RenoZhao19/Hexfellow-Teleop-Leader-Arm-Design/Checks/Measured_CAD_shafts.csv

side | axis | component | largest matching cylindrical diameter mm | direction residual (sine of unsigned angle) | perpendicular shaft offset mm | matching cylindrical face count
Left | 1 | J1_XM430_drive_horn | 19.5 | 0.0 | 0.0 | 6
Left | 2 | M2_XM430_drive_horn | 19.5 | 0.0 | 0.0 | 3
Left | 3 | M3_XC330_horn | 16.0 | 0.0 | 0.0 | 14
Left | 4 | M4_XM430_drive_horn | 19.5 | 0.0 | 0.0 | 3
Left | 5 | M5_XC330_horn | 16.0 | 0.0 | 0.0 | 14
Left | 6 | M6_XC330_horn | 16.0 | 0.0 | 0.0 | 14
Left | 7 | M7_XC330_horn | 16.0 | 0.0 | 0.0 | 14
Right | 1 | J1_XM430_drive_horn | 19.5 | 0.0 | 0.0 | 6
Right | 2 | M2_XM430_drive_horn | 19.5 | 0.0 | 0.0 | 3
Right | 3 | M3_XC330_horn | 16.0 | 0.0 | 0.0 | 14
Right | 4 | M4_XM430_drive_horn | 19.5 | 0.0 | 0.0 | 3
Right | 5 | M5_XC330_horn | 16.0 | 0.0 | 0.0 | 14
Right | 6 | M6_XC330_horn | 16.0 | 0.0 | 0.0 | 14
Right | 7 | M7_XC330_horn | 16.0 | 0.0 | 0.0 | 14
