RenoZhao19/Hexfellow-Teleop-Leader-Arm-Design/Assemblies/Right_leader.step

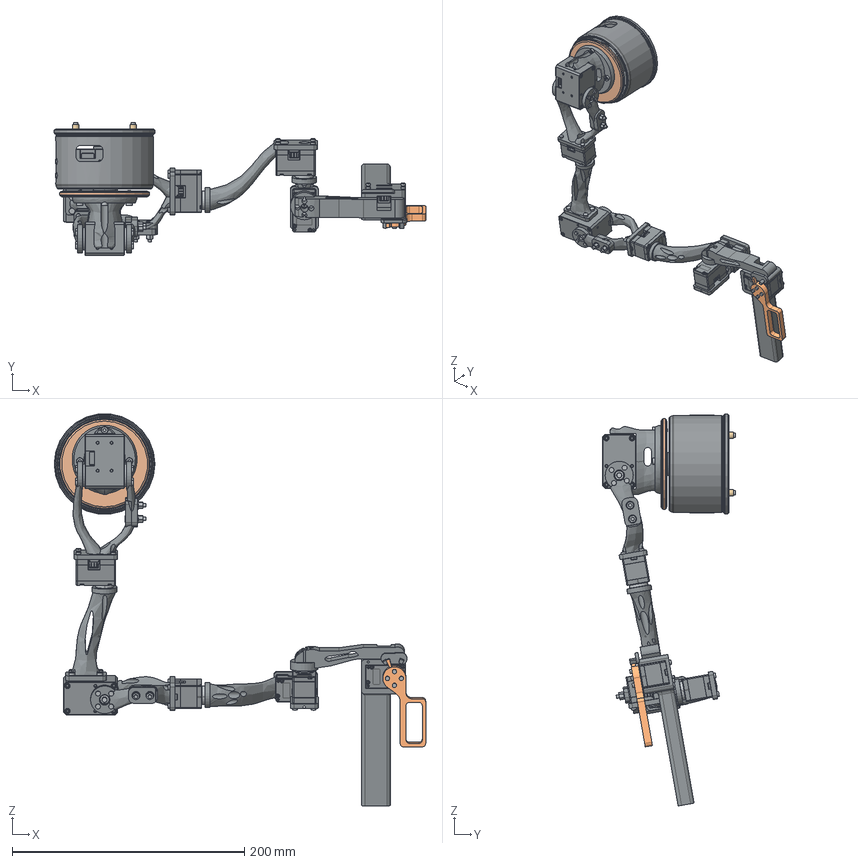
[picture p8: CAD file, 2026-11-11]
Assemblies/Right_leader.step
319.8 x 114.2 x 337.4 mm
Right_L2_Upper_fork
Right_L2_Upper_service_cheek
Right_M2_XM430_case
Right_M2_XM430_drive_horn
Right_M2_XM430_idler
Right_F1_Exterior_fasteners
Right_J1_Fixed_external_drum
Right_J1_XM430_fixed_case
Right_J1_XM430_drive_horn
Right_J1_Drum_mount_M4x14
Right_J1_Torso_M4_inserts
Right_J1_Case_mount_M25x7
Right_J1_Rotating_faceplate
Right_J1_J2_Swept_motor_saddle
Right_J1_Horn_drive_screws_M2x6
Right_J1_Saddle_screws_M3x10
Right_J1_Saddle_captive_nuts_M3
Right_L4_Elbow_fork
Right_L4_Elbow_service_cheek
Right_L3_Upper_bone
Right_L5_Forearm_bone
Right_L6_Wrist_saddle
Right_M3_XC330_case
Right_M3_XC330_horn
Right_M4_XM430_case
Right_M4_XM430_drive_horn
Right_M4_XM430_idler
Right_M5_XC330_case
Right_M5_XC330_horn
Right_M6_XC330_case
Right_M6_XC330_horn
Right_M7_XC330_case
Right_F2_Exterior_fasteners
Right_F3_Exterior_fasteners
Right_F4_Exterior_fasteners
Right_F5_Exterior_fasteners
Right_F6_Exterior_fasteners
Right_M7_XC330_horn
Right_FACTR_palm
Right_FACTR_trigger
Right_J8_XC330_T288T_case
Right_J8_XC330_T288T_horn
Right_J7_grip_screws
Right_J8_case_screws
Right_J8_trigger_screws
