RenoZhao19/Hexfellow-Teleop-Leader-Arm-Design/CAD_Source/grip/trigger.step

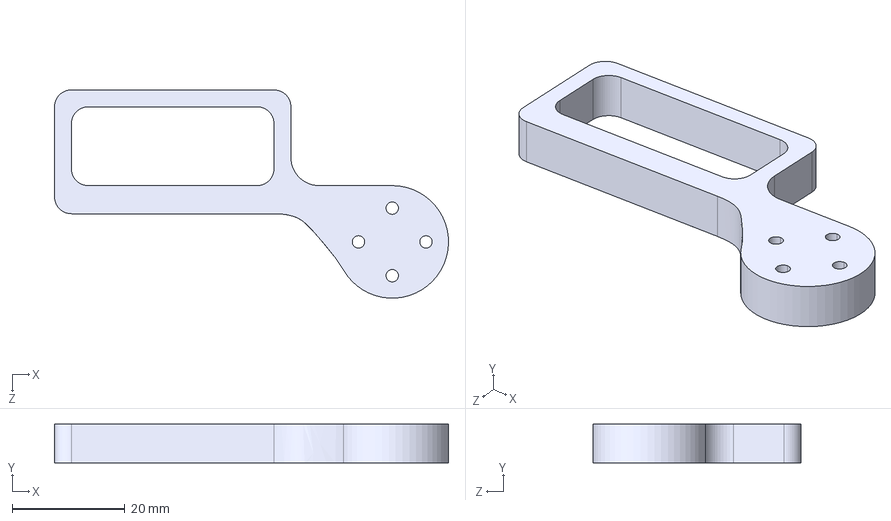
[picture p9: CAD file, 2026-11-11]
CAD_Source/grip/trigger.step
70.0 x 6.90 x 37.0 mm
