RenoZhao19/Hexfellow-Teleop-Leader-Arm-Design/Parts/Metal/F03_Square_mast_40x40x2_L453.step

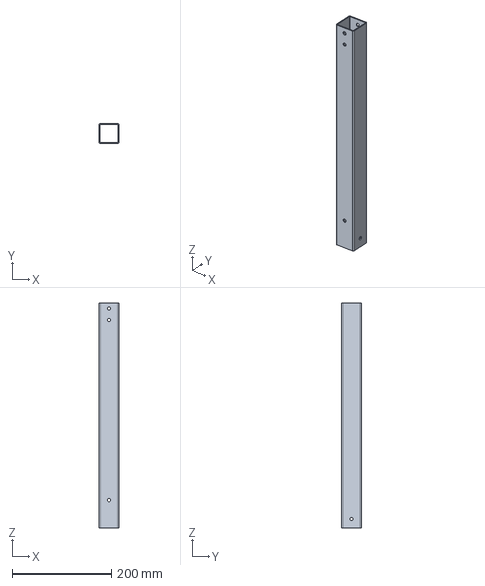
[picture p10: CAD file, 2026-11-11]
Parts/Metal/F03_Square_mast_40x40x2_L453.step
40.0 x 40.0 x 453.0 mm
