RenoZhao19/Hexfellow-Teleop-Leader-Arm-Design/Parts/Printable_STEP/J1_Fixed_external_drum.step

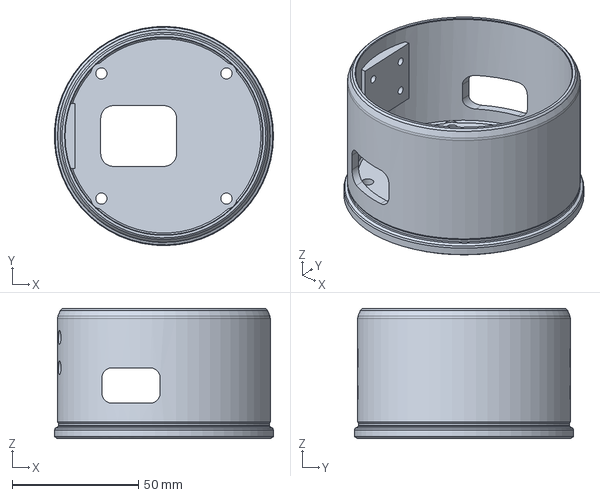
[picture p11: CAD file, 2026-11-11]
Parts/Printable_STEP/J1_Fixed_external_drum.step
86.6 x 86.7 x 51.5 mm
