RenoZhao19/Hexfellow-Teleop-Leader-Arm-Design/CAD_Source/grip/handle.step

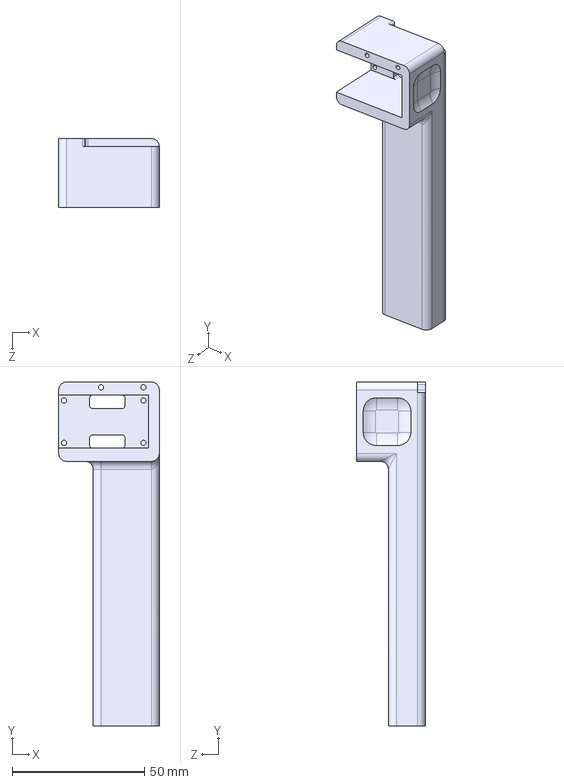
[picture p12: CAD file, 2026-11-11]
CAD_Source/grip/handle.step
38.0 x 130.0 x 26.0 mm
