RenoZhao19/Hexfellow-Teleop-Leader-Arm-Design/Parts/Metal/F04_Mast_sleeve_36mm.step

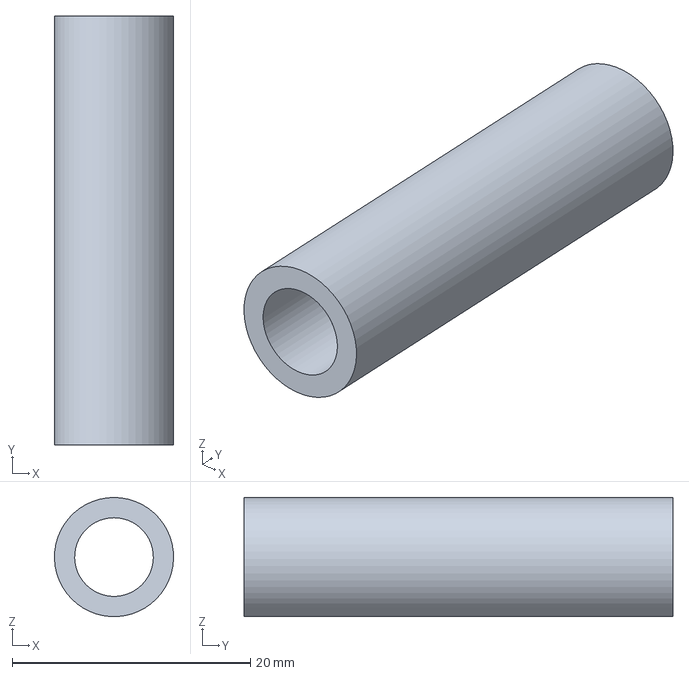
[picture p13: CAD file, 2026-11-11]
Parts/Metal/F04_Mast_sleeve_36mm.step
10.00 x 36.0 x 9.99 mm
