RenoZhao19/Hexfellow-Teleop-Leader-Arm-Design/Parts/Printable_STEP/J1_J2_Swept_motor_saddle.step

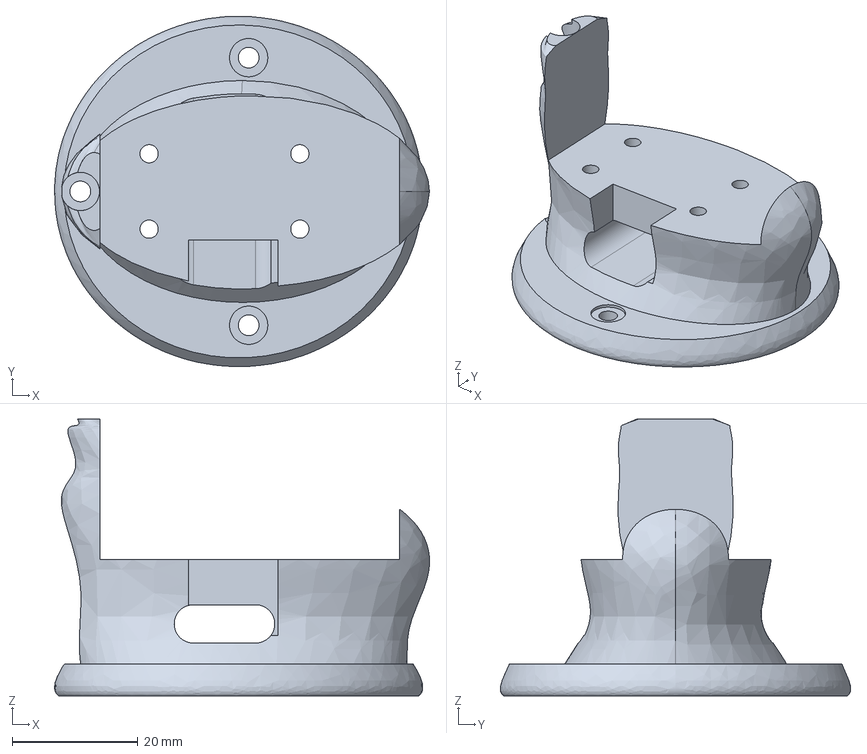
[picture p14: CAD file, 2026-11-11]
Parts/Printable_STEP/J1_J2_Swept_motor_saddle.step
59.7 x 55.8 x 44.1 mm
