RenoZhao19/Hexfellow-Teleop-Leader-Arm-Design/Assemblies/Left_leader.step

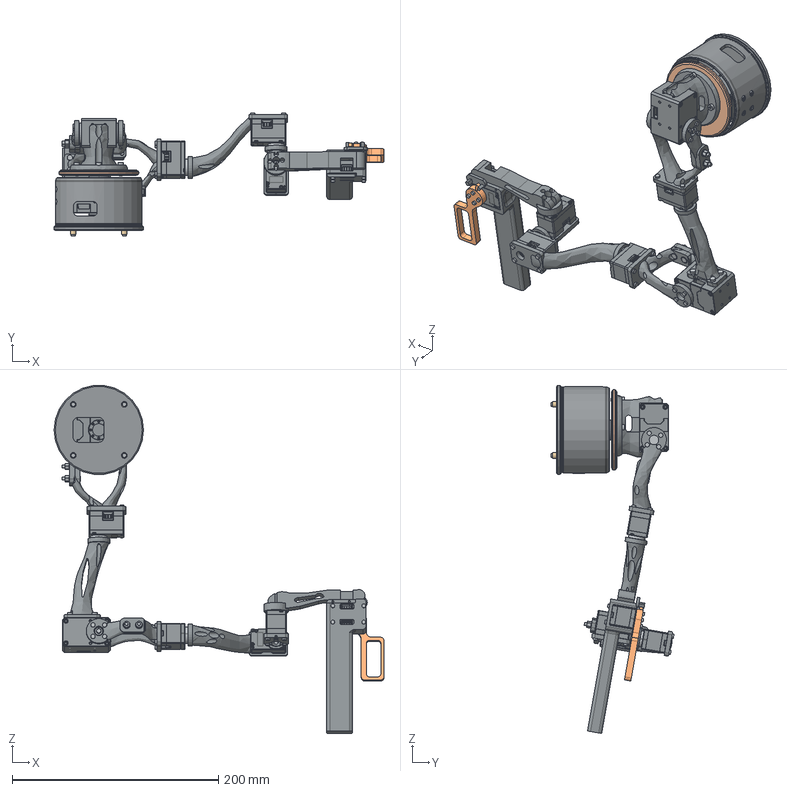
[picture p15: CAD file, 2026-11-11]
Assemblies/Left_leader.step
319.8 x 119.5 x 337.4 mm
Left_L2_Upper_fork
Left_L2_Upper_service_cheek
Left_M2_XM430_case
Left_M2_XM430_drive_horn
Left_M2_XM430_idler
Left_F1_Exterior_fasteners
Left_J1_Fixed_external_drum
Left_J1_XM430_fixed_case
Left_J1_XM430_drive_horn
Left_J1_Drum_mount_M4x14
Left_J1_Torso_M4_inserts
Left_J1_Case_mount_M25x7
Left_J1_Rotating_faceplate
Left_J1_J2_Swept_motor_saddle
Left_J1_Horn_drive_screws_M2x6
Left_J1_Saddle_screws_M3x10
Left_J1_Saddle_captive_nuts_M3
Left_L4_Elbow_fork
Left_L4_Elbow_service_cheek
Left_L3_Upper_bone
Left_L5_Forearm_bone
Left_L6_Wrist_saddle
Left_M3_XC330_case
Left_M3_XC330_horn
Left_M4_XM430_case
Left_M4_XM430_drive_horn
Left_M4_XM430_idler
Left_M5_XC330_case
Left_M5_XC330_horn
Left_M6_XC330_case
Left_M6_XC330_horn
Left_M7_XC330_case
Left_F2_Exterior_fasteners
Left_F3_Exterior_fasteners
Left_F4_Exterior_fasteners
Left_F5_Exterior_fasteners
Left_F6_Exterior_fasteners
Left_M7_XC330_horn
Left_FACTR_palm
Left_FACTR_trigger
Left_J8_XC330_T288T_case
Left_J8_XC330_T288T_horn
Left_J7_grip_screws
Left_J8_case_screws
Left_J8_trigger_screws
