RenoZhao19/Hexfellow-Teleop-Leader-Arm-Design/Parts/Metal/F03_Square_mast_40x40x2_L562.step

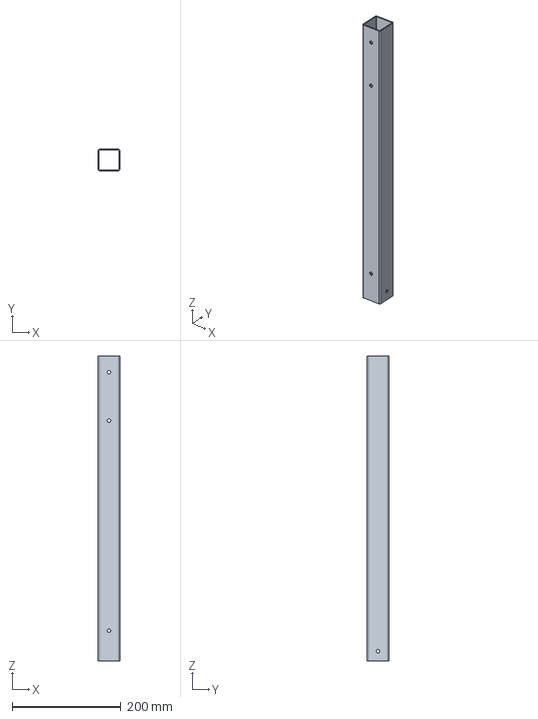
[picture p16: CAD file, 2026-11-11]
Parts/Metal/F03_Square_mast_40x40x2_L562.step
40.0 x 40.0 x 562.0 mm
