RenoZhao19/Hexfellow-Teleop-Leader-Arm-Design/Parts/Printable_STEP/J1_Rotating_faceplate.step

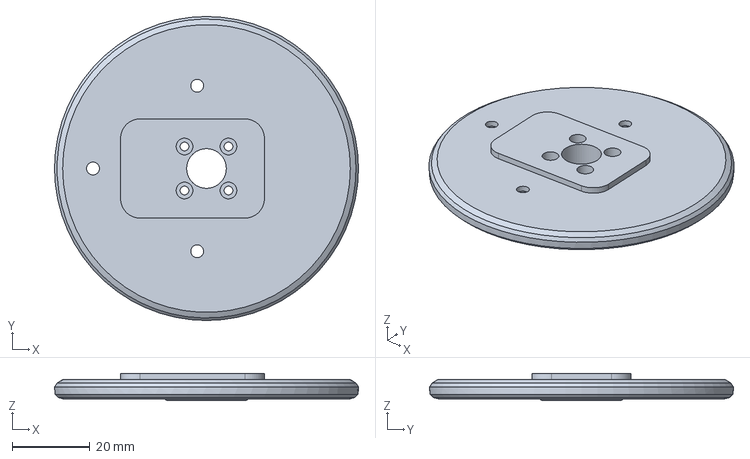
[picture p17: CAD file, 2026-11-11]
Parts/Printable_STEP/J1_Rotating_faceplate.step
78.2 x 78.2 x 7.05 mm
