RenoZhao19/Hexfellow-Teleop-Leader-Arm-Design/Assemblies/Bimanual_leader.step

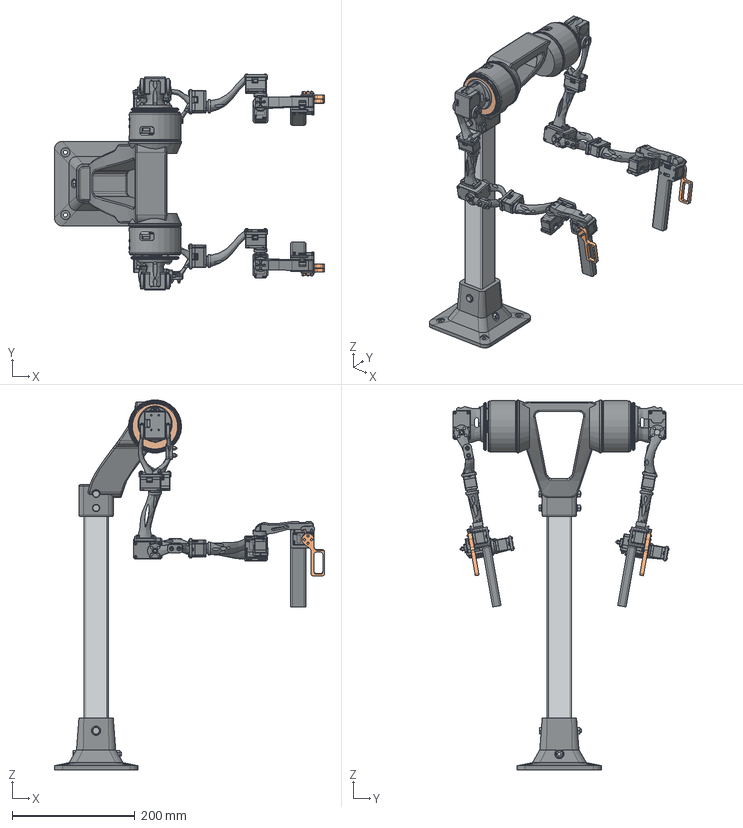
[picture p18: CAD file, 2026-11-11]
Assemblies/Bimanual_leader.step
440.4 x 352.7 x 603.0 mm
F01_Arched_torso
F02_Flared_table_foot
F03_Square_mast_40x40x2_L453
F04_Mast_sleeve_1
F04_Mast_sleeve_2
F04_Mast_sleeve_3
F04_Mast_sleeve_4
F05_M6x65_post_pin_1
F05_M6x75_post_pin_2
F05_M6x65_post_pin_3
F05_M6x65_post_pin_4
Left_L2_Upper_fork x 2
Left_L2_Upper_service_cheek x 2
Left_M2_XM430_case x 2
Left_M2_XM430_drive_horn x 2
Left_M2_XM430_idler x 2
Left_F1_Exterior_fasteners x 2
Left_J1_Fixed_external_drum x 2
Left_J1_XM430_fixed_case x 2
Left_J1_XM430_drive_horn x 2
Left_J1_Drum_mount_M4x14 x 2
Left_J1_Torso_M4_inserts x 2
Left_J1_Case_mount_M25x7 x 2
Left_J1_Rotating_faceplate x 2
Left_J1_J2_Swept_motor_saddle x 2
Left_J1_Horn_drive_screws_M2x6 x 2
Left_J1_Saddle_screws_M3x10 x 2
Left_J1_Saddle_captive_nuts_M3 x 2
Left_L4_Elbow_fork x 2
Left_L4_Elbow_service_cheek x 2
Left_L3_Upper_bone x 2
Left_L5_Forearm_bone x 2
Left_L6_Wrist_saddle x 2
Left_M3_XC330_case x 2
Left_M3_XC330_horn x 2
Left_M4_XM430_case x 2
Left_M4_XM430_drive_horn x 2
Left_M4_XM430_idler x 2
Left_M5_XC330_case x 2
Left_M5_XC330_horn x 2
Left_M6_XC330_case x 2
Left_M6_XC330_horn x 2
Left_M7_XC330_case x 2
Left_F2_Exterior_fasteners x 2
Left_F3_Exterior_fasteners x 2
Left_F4_Exterior_fasteners x 2
Left_F5_Exterior_fasteners x 2
Left_F6_Exterior_fasteners x 2
Left_M7_XC330_horn x 2
Left_FACTR_palm
Left_FACTR_trigger
Left_J8_XC330_T288T_case
Left_J8_XC330_T288T_horn
Left_J7_grip_screws
Left_J8_case_screws
Left_J8_trigger_screws
Right_FACTR_palm
Right_FACTR_trigger
Right_J8_XC330_T288T_case
Right_J8_XC330_T288T_horn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
