RenoZhao19/Hexfellow-Teleop-Leader-Arm-Design/Parts/Printable_STEP/F01_Arched_torso.step

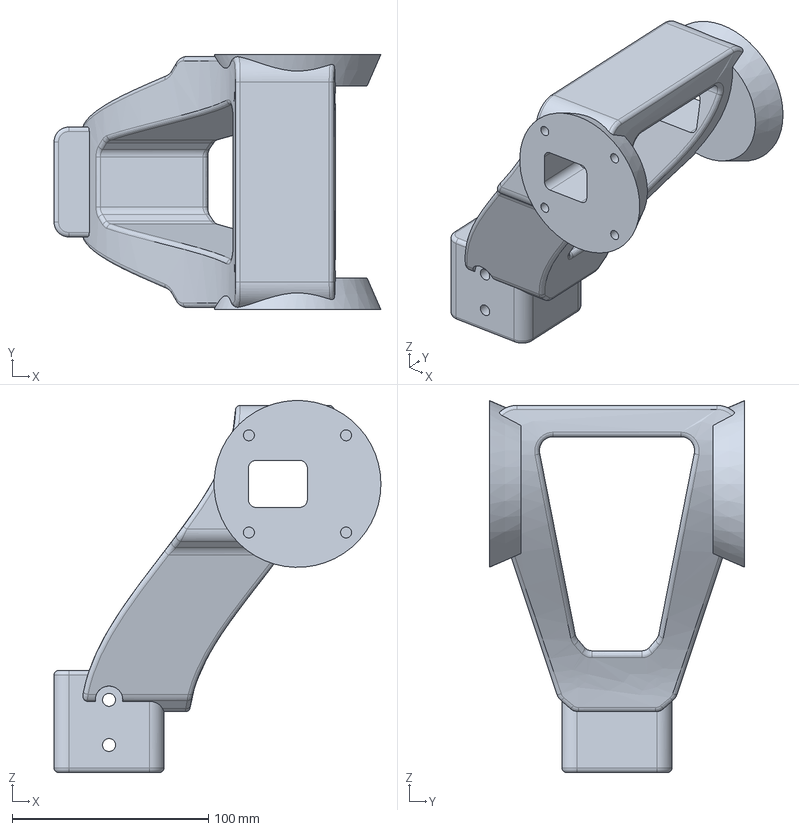
[picture p19: CAD file, 2026-11-11]
Parts/Printable_STEP/F01_Arched_torso.step
166.5 x 130.0 x 189.5 mm
