RenoZhao19/Hexfellow-Teleop-Leader-Arm-Design/Assemblies/Grip_released.step

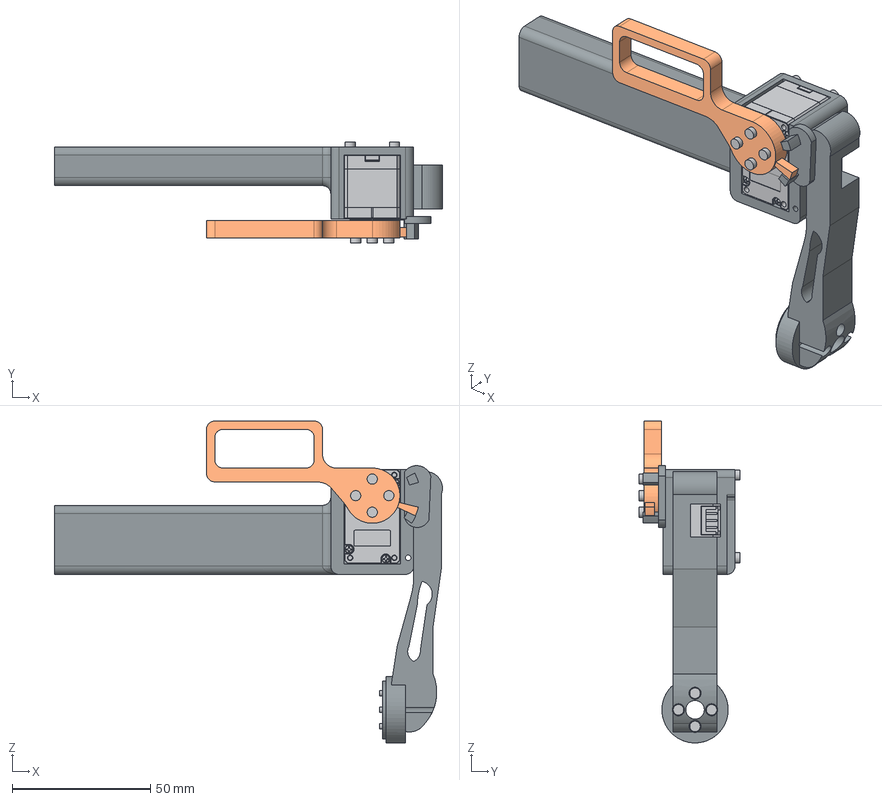
[picture p20: CAD file, 2026-11-11]
Assemblies/Grip_released.step
140.4 x 36.6 x 116.5 mm
Left_FACTR_palm
Left_FACTR_trigger
Left_J8_XC330_T288T_case
Left_J8_XC330_T288T_horn
Left_J7_grip_screws
Left_J8_case_screws
Left_J8_trigger_screws
