RenoZhao19/Hexfellow-Teleop-Leader-Arm-Design/Parts/Printable_STEP/L4_Elbow_service_cheek.step

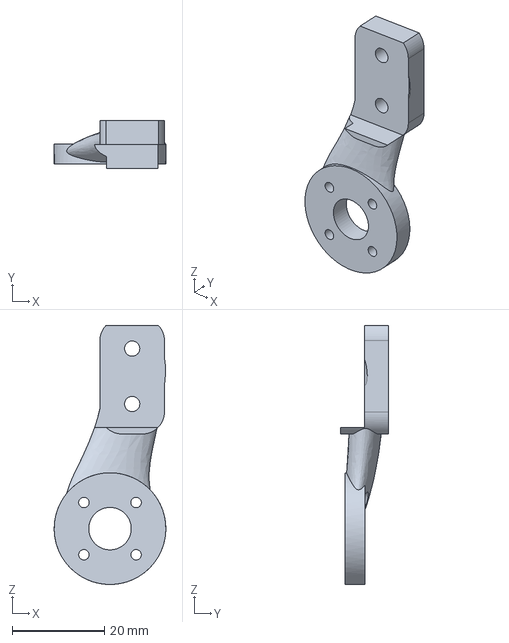
[picture p21: CAD file, 2026-11-11]
Parts/Printable_STEP/L4_Elbow_service_cheek.step
24.2 x 10.5 x 56.1 mm
