RenoZhao19/Hexfellow-Teleop-Leader-Arm-Design/Parts/Printable_STEP/Left_FACTR_trigger.step

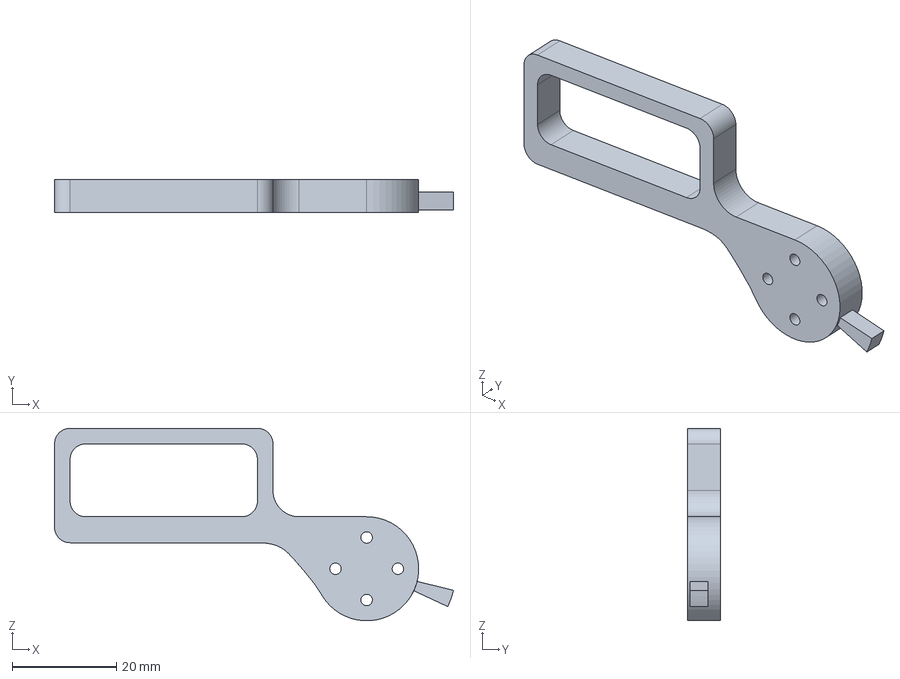
[picture p23: CAD file, 2026-11-11]
Parts/Printable_STEP/Left_FACTR_trigger.step
76.7 x 6.30 x 37.0 mm
