RenoZhao19/Hexfellow-Teleop-Leader-Arm-Design/Parts/Printable_STEP/F02_Flared_table_foot.step

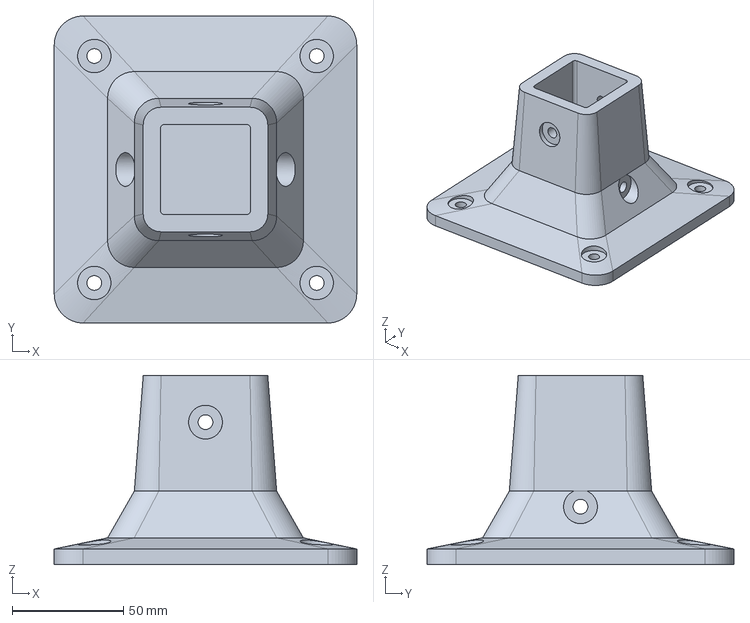
[picture p24: CAD file, 2026-11-11]
Parts/Printable_STEP/F02_Flared_table_foot.step
136.0 x 138.0 x 85.0 mm
