RenoZhao19/Hexfellow-Teleop-Leader-Arm-Design/Parts/Printable_STEP/L6_Wrist_saddle.step

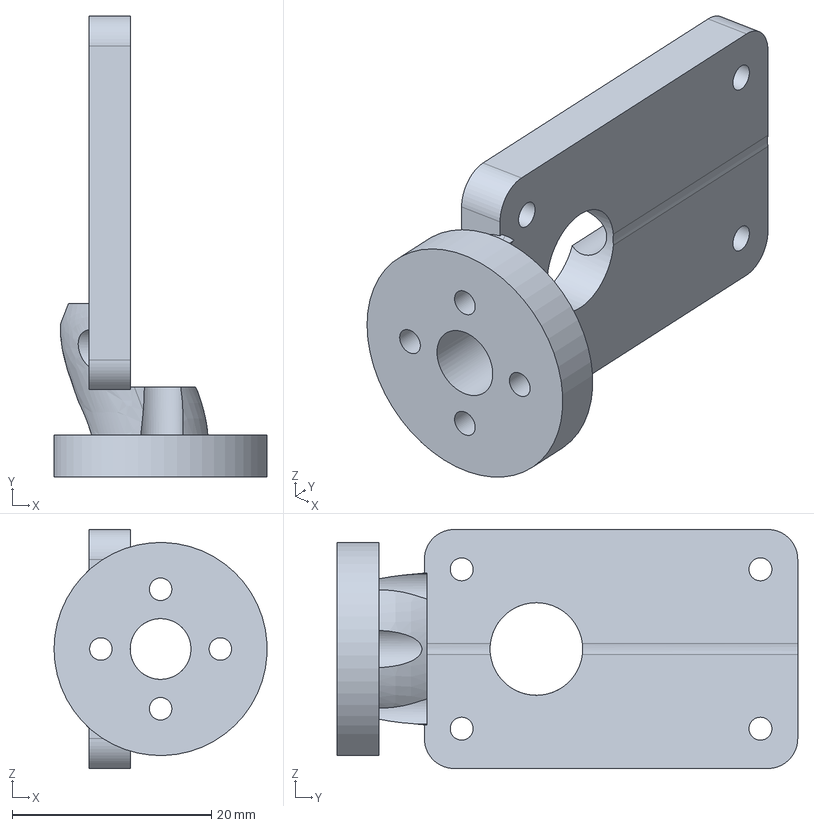
[picture p25: CAD file, 2026-11-11]
Parts/Printable_STEP/L6_Wrist_saddle.step
21.4 x 46.2 x 24.0 mm
