RenoZhao19/Hexfellow-Teleop-Leader-Arm-Design/Parts/Printable_STEP/L4_Elbow_fork.step

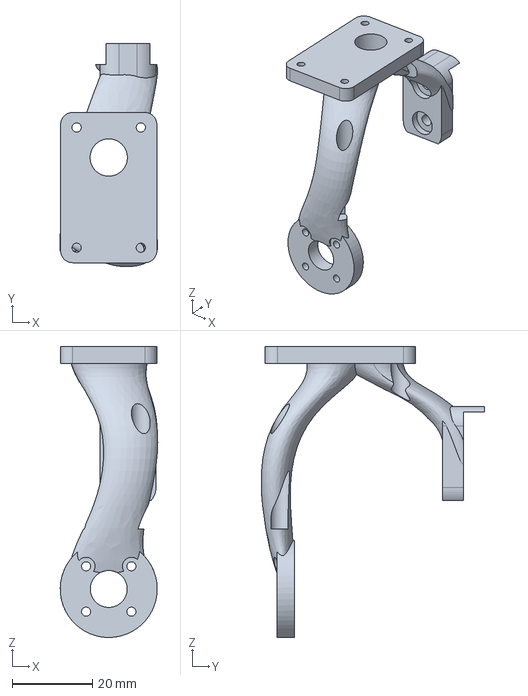
[picture p26: CAD file, 2026-11-11]
Parts/Printable_STEP/L4_Elbow_fork.step
24.3 x 55.7 x 72.6 mm
