RenoZhao19/Hexfellow-Teleop-Leader-Arm-Design/Parts/Printable_STEP/L3_Upper_bone.step

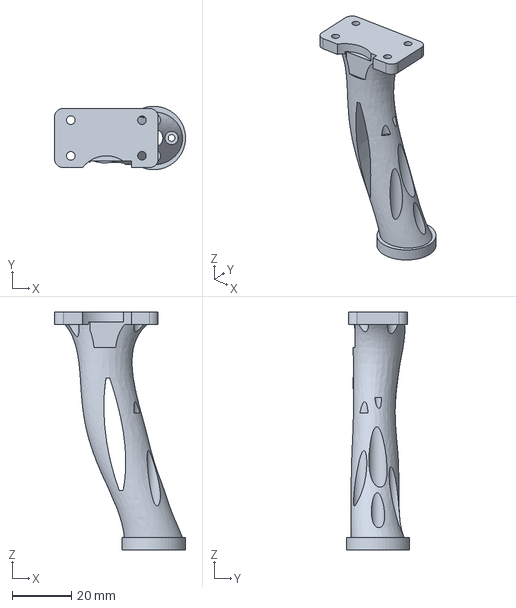
[picture p27: CAD file, 2026-11-11]
Parts/Printable_STEP/L3_Upper_bone.step
44.2 x 21.4 x 80.3 mm
