RenoZhao19/Hexfellow-Teleop-Leader-Arm-Design/Parts/Printable_STEP/L2_Upper_fork.step

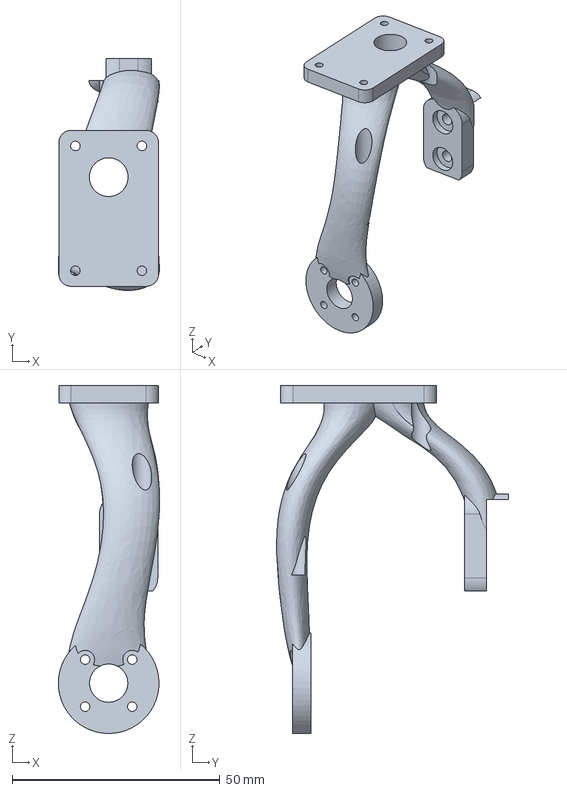
[picture p28: CAD file, 2026-11-11]
Parts/Printable_STEP/L2_Upper_fork.step
24.4 x 55.7 x 83.7 mm
