RenoZhao19/Hexfellow-Teleop-Leader-Arm-Design/Parts/Printable_STEP/Left_FACTR_palm.step

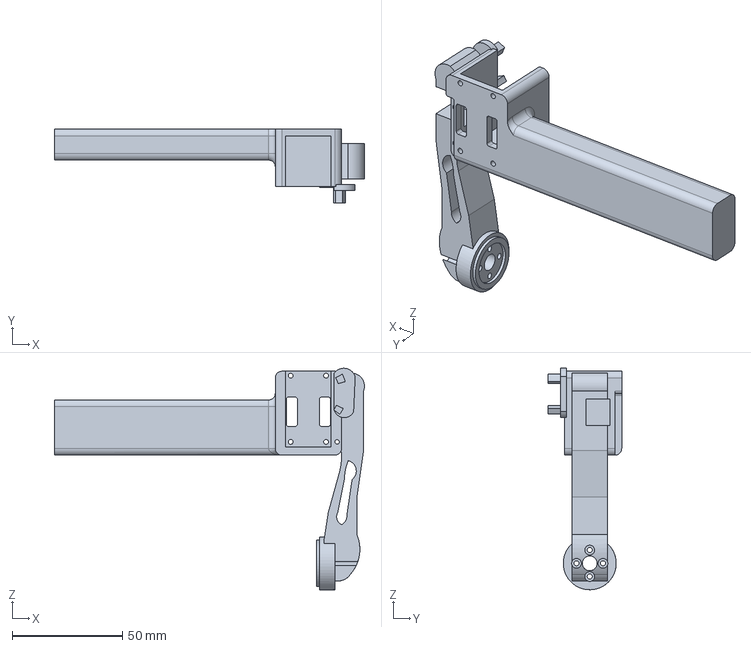
[picture p29: CAD file, 2026-11-11]
Parts/Printable_STEP/Left_FACTR_palm.step
140.4 x 33.3 x 100.4 mm
