RenoZhao19/Hexfellow-Teleop-Leader-Arm-Design/Parts/Printable_STEP/L5_Forearm_bone.step

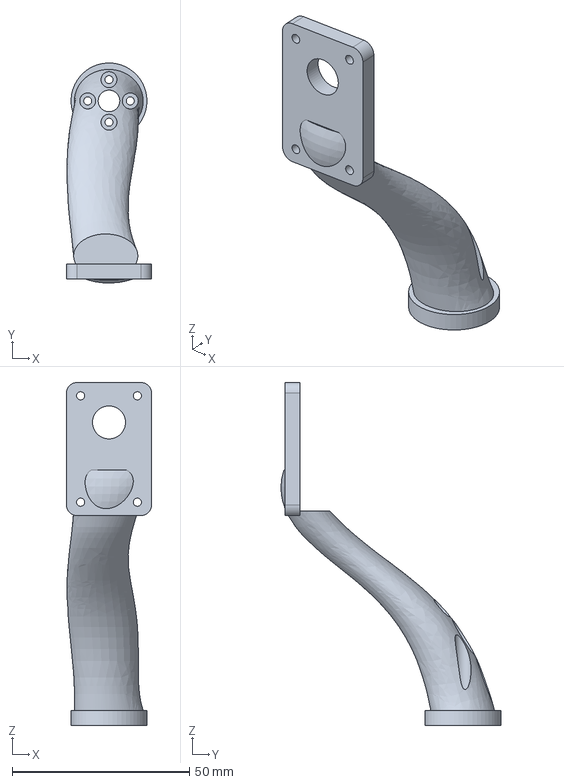
[picture p30: CAD file, 2026-11-11]
Parts/Printable_STEP/L5_Forearm_bone.step
24.0 x 62.0 x 96.7 mm
