RenoZhao19/Hexfellow-Teleop-Leader-Arm-Design/(list of files, cad)

Other CAD files:
Assemblies/Poseable_leader.FCStd
Parts/Printable_STEP/Right_FACTR_trigger.step
Parts/Printable_STEP/Right_FACTR_palm.step
Parts/Printable_STEP/L2_Upper_service_cheek.step
Parts/Printable_STL/F01_Arched_torso.stl
Parts/Printable_STL/F02_Flared_table_foot.stl
Parts/Printable_STL/J1_Fixed_external_drum.stl
Parts/Printable_STL/J1_J2_Swept_motor_saddle.stl
Parts/Printable_STL/J1_Rotating_faceplate.stl
Parts/Printable_STL/L2_Upper_fork.stl
Parts/Printable_STL/L2_Upper_service_cheek.stl
Parts/Printable_STL/L3_Upper_bone.stl
Parts/Printable_STL/L4_Elbow_fork.stl
Parts/Printable_STL/L4_Elbow_service_cheek.stl
Parts/Printable_STL/L5_Forearm_bone.stl
Parts/Printable_STL/L6_Wrist_saddle.stl
Parts/Printable_STL/Left_FACTR_palm.stl
Parts/Printable_STL/Left_FACTR_trigger.stl
Parts/Printable_STL/Right_FACTR_palm.stl
Parts/Printable_STL/Right_FACTR_trigger.stl
