RenoZhao19/Hexfellow-Teleop-Leader-Arm-Design/Design/Hardware_buying_guide.md

# Hardware buying guide · external-drum leader

The quantities below cover one tabletop station, both arms and both triggers. Each arm uses **three XM430-W210-T** at J1, J2 and J4, and **five XC330-T288-T** at J3, J5, J6, J7 and J8. J1 drives the external faceplate directly through the XM430 horn. The separate rear idler sets are used only at J2 and J4.

**Fabricate 26 prints from 16 designs and 5 metal pieces from 2 designs.** The metal pieces are one mast and four internal sleeves. The installed screw count is **174 external mounting screws** including the four bench bolts, plus **16 factory horn-center retainers**. There are 22 loose nuts, 32 flat mounting washers, 6 factory horn thrust washers and 8 heat-set inserts. These quantities exclude spare kit hardware, cables and the fasteners already inside the servos. [Print quantities](CAD_parts_and_quantities.csv) · [Shoulder assembly](Shoulder_assembly.md) · [Arm and grip assembly](Arm_interfaces.md)

## Order list

All dimensions are in mm. A machine screw is specified as diameter × pitch × **under-head length**. Every screw in this build seats on a flat underside. Ø refers to diameter and AF to width across flats. Keep the two different M2 × 6 machine heads, the two M2.5 × 7 machine heads, and the XC330 plastic taps in separate bags. Order quantities are installed counts. Subtract matching items already in your motor boxes.

| Specify when ordering | Per station | Used at | Fit or source |
|---|---:|---|---|
| 6061 square aluminum tube, 40 × 40 × 2 wall, cut length **453** | 1 | F03 post | Center four Ø6.6 cross holes from the lower cut end at 18, 56, 419 and 442. See the drilling directions before cutting. [Mast drilling layout](Shoulder_assembly.md#prepare-the-stand) |
| Aluminum crush sleeve, Ø10 outside × Ø6.6 bore × 36 long | 4 | Inside F03 at each crossbolt | Cut and face tube or drill aluminum rod. Gauge the actual inside width. A sleeve must bear on both walls. [Metal STEP files](../Parts/Metal/) |
| M6 × 1.0 × 75 hex-head bolt, 10 AF | 1 | F02 lower crossbolt at 18 | Use a flat washer on each side and one M6 nut. |
| M6 × 1.0 × 65 hex-head bolt, 10 AF | 3 | F02 at 56 and F01 at 419, 442 | CAD assumes 10 AF × 4 high heads. Check that full threads reach through each nut. |
| M6 × 1.0 hex-head bolt, 10 AF, **length from bench thickness** | 4 | Foot to table, 100 × 102 hole centers | For a 25 mm bench without a backer, the example below uses M6 × 45. |
| M6 × 1.0 plain hex nut, 10 AF × 5 high | 8 | 4 mast bolts and 4 bench bolts | ISO/DIN equivalents can differ in thickness. Match the dimensions or recalculate length. |
| Flat washer, Ø6.4 bore × Ø12 outside × 1.6 | 16 | Both sides of each of the 8 M6 bolts | Check the head/washer and chosen socket fit the actual foot recesses. |
| M4 × 0.7 × 14 **unflanged** button socket head, ≤Ø7.6 × 2.2, 2.5 hex | 8 | F01 to fixed J1 drum, 4/side | ISO 7380-1, Ø70 bolt circle. [M4 × 14 example](https://macdonaldindustrial.com/product/m4-0-7x14mm-button-head-socket-cap-screw-a2-stainless-steel-iso-7380-full-thread/) |
| Short M4 × 0.7 heat-set insert, ruthex **RX-M4Sx4.0**, Ø6.3 knurl × 4 long | 8 | 4 in each end of F01 | Ø5.6 × 7.4 deep printed pockets. Full-length M4 inserts exceed the depth. [ruthex GE-M4Sx04-1](https://www.ruthex.de/en/products/ruthex-gewindeeinsatz-m4s-50-stuck-rx-m4x4-0-short-messing-gewindebuchsen-fur-3d-druck) |
| M2.5 × 0.45 × 7 **socket cap head**, ≤Ø4.5 × 2.5, 2 hex | 8 | J1 XM430 case to outside drum wall, 4/side | Four ports on a 16 × 12 rectangle. The RC seller lists the length and grade. Verify the actual head and under-head length against the callout. [Locked Up RC 1211-M2.5x7](https://www.lockeduprc.com/M25-x-7-socket-head-screws-30-black-_p_1255.html) |
| M2 × 0.4 × 6 **socket cap head**, ≤Ø3.8 × 2, 1.5 hex | 8 | J1 faceplate to driven horn, 4/side | ISO 4762, Ø16 bolt circle. The factory M2 × 5 would reach only 0.8 into this horn. [Accu SSCF-M2-6-A2](https://accu-components.com/us/metric-cap-head-screws/3792-SSCF-M2-6-A2) |
| M3 × 0.5 × 10 socket cap head, ≤Ø5.5 × 3, 2.5 hex | 6 | J2 saddle to J1 faceplate, 3/side | Insert from the arm side. [Accu SSCF-M3-10-A4](https://accu-components.com/us/metric-cap-head-screws/3975-SSCF-M3-10-A4) |
| M3 × 0.5 **plain DIN 934 hex nut**, 5.5 AF × 2.4 high | 6 | Inboard face of rotating plate, 3/side | Drop into the three 5.68 AF pockets before mounting the plate. [Spaenaur 156-010ZP](https://spaenaur.com/products/156-010zp) |
| M2.5 × 0.45 × 7 **pan head**, ≤Ø5.1 × 2.3 | 16 | Fixed J2 case to saddle and fixed J4 case to L3, 4/case | 4.3 printed land leaves 2.7 inside the case, maximum 3.0. Check the driver's shank passes the deep access bores. [DIN 7985A, 535641](https://www.fastenersuperstore.com/products/535641/machine-screws) |
| M2 × 0.4 × 6 **low socket head**, ≤Ø4.2 × 1.5 | 32 | J2 and J4 fork cheeks, 4 per drive face **and** 4 per idler face | NBK SLH-M2-6 is Ø3.8 × 1.3 and uses a 1.3 hex key. 4.35 of cheek leaves 1.65 into a 2.0 maximum tap. [NBK SLH-M2-6](https://www.nbk1560.com/en-US/products/specialscrew/nedzicom/socketheadcapscrew/SLH/SLH-M2/SLH-M2-6/) |
| M3 × 0.5 × 16 button socket head, ≤Ø5.7 × 1.75 | 8 | Removable J2 and J4 fork cheeks, 2/fork | ISO 7380-1 unflanged. Head toward motor. |
| M3 × 0.5 **locking nut**, 5.5 AF × ≤4 high | 8 | Outboard side of the 8 fork lap bolts | Select a low-profile prevailing-torque nut. Check that full thread reaches the locking element. |
| Flat washer, Ø3.2 bore × Ø7 outside × 0.5 | 16 | Both sides of each fork lap bolt | One under each head and nut. |
| **2 × 12 plastic tapping screw**, head ≤Ø4.3 × 1.7 | 32 | Fixed XC330 rear cases at J3, J5, J6 and J7, 4/case | Through 4.2 of print and a 4.5 case entrance, the tip reaches 3.3 into the narrower pilot. Obtain a thread-matched sample. |
| **2 × 7 plastic tapping screw**, head ≤Ø4.3 × 1.7 | 24 | J3, J5 and J6 output horns, 4/horn | Through 4.2 of print, tip enters 2.8, only 0.2 below the horn's 3.0 maximum. |
| **2 × 10 plastic tapping screw**, head ≤Ø3.7 × 1.8 | 8 | J8 rear case to palm, 4/palm | Through 3.0 of palm and a 4.5 case entrance, tip reaches 2.5 into the narrower pilot. |
| **2 × 6 plastic tapping screw**, shared head ≤Ø3.7 × 1.7 | 16 | J7 horn to palm, 4/hand, and J8 horn to lever, 4/hand | Use matching factory PHS TAP if the head fits. Tip enters the J7 horn 2.3, J8 horn 2.0. |
| ROBOTIS XM430-W210-**T**, TTL | 6 | J1, J2, J4 each arm | The listed box includes HN12-N101, cables, M2 × 5, M2.5 × 14, tapping screws and spacers. Inventory each pack. [ROBOTIS XM430](https://robotis.us/products/dynamixel-xm430-w210-t) |
| HN12-N101 driven horn, OEM WB M2.5 × 0.45 × 6 center screw, matched thrust washer | 6 sets | One set per XM430 | Count supplied or preinstalled parts first. The horn set lists the center screw and washer. [ROBOTIS HN12-N101](https://robotis.us/products/hn12-n101-set) |
| HN12-I101 rear idler, plastic bearing and DC12 cap | 4 sets | J2 and J4 each arm | The snap-in set supports the other fork cheek. Use the separate low-head M2 × 6 screws in the table for these cheeks. [ROBOTIS HN12-I101](https://robotis.us/products/hn12-i101-set) |
| ROBOTIS XC330-T288-**T**, stock plastic horn and factory **BTS2 M2.6 × 8** center retainer | 10 sets | J3, J5, J6, J7 and J8 each arm | Retain the factory center screw and horn supplied on the unit. Its center screw is distinct from the four perimeter taps. Verify supplied hardware on delivery. [ROBOTIS XC330](https://robotis.us/products/dynamixel-xc330-t288-t) |
| X-series 3-pin TTL JST–JST leads | 14 between servos, plus controller lead(s) | Seven inter-servo runs per side, ending at J8 | Both motor listings include a 180 mm JST–JST lead. Measure each run through the intended motion before ordering replacements or longer leads. Controller, power supply and software depend on the bench setup. |

**Bench bolt length.** Add 8 mm of printed foot below the recess, bench and backer thicknesses, two 1.6 mm washers, 5 mm for the nut and the desired thread protrusion. For 25 mm of bench and 2 mm of protrusion this gives 43.2 mm. Choose M6 × 45 for that stack and verify clearance underneath. The two upper mast bolts have just 0.8 mm nominal protrusion with the specified washers and nuts, so check engagement before tightening.

**Qualify one XC330 before ordering a bulk pack.** The 2 mm plastic screw callouts give diameter and under-head length. ROBOTIS identifies its included PHS TAP but does not give a steel machine-thread pitch for these plastic pilots. Each motor's packing list includes six PHS M2 × 6 TAP and ten PHS M2 × 8 TAP. Use the factory screw to match the thread profile, pitch, tip and head. The 2 × 8 gives only 0.5 mm into the narrower J8 rear pilot and exceeds the J8 horn depth by 1 mm. [ROBOTIS supplied screws](https://www.robotis.com/shop/item_export_only.php?it_id=902-0171-000) · [XC330 drawings](https://emanual.robotis.com/docs/en/dxl/x/xc330-t288/#drawings)

For the 7, 10 and 12 mm lengths, request a supplier sample such as **EJOT DELTA PT size 20, WN 5452 pan head**. Nominal head Ø3.5 × 1.6 fits the listed envelopes. Compatibility with ROBOTIS plastic and existing formed threads, point depth, actual length tolerance and availability at these lengths need supplier and physical confirmation. Measure projection through the real print and receiving depth on an unpowered motor. Check retention on a spare before purchasing all 80 screws. The guide does not establish a qualified substitute or tightening torque for these taps. [EJOT supplier](https://www.ejot-atf.com/product/delta-pt/) · [Size 20 dimensions and pilot guidance](https://www.bulten.com/media/b5eby1nc/deltapt-version-250422.pdf)

**First fit.** The useful first purchase is one J1 XM430 with its factory horn, four of each J1 M4, M2.5 and M2 screw, four short inserts, and three M3 saddle bolts with three plain nuts. Add one J2 XM430/idle set and the J2 row quantities to check an entire shoulder pitch assembly. This catches horn fit, socket access, insert seating and loaded sag before duplicating both arms. Use one XC330 with the stock plastic horn to qualify the distal screws separately.

**Powered bench setup.** A ROBOTIS U2D2 provides the USB-to-TTL communication link. Supply motor power separately through suitable distribution with adjustable current limiting. The overlapping published input range of these two T-series motors is **10–12 V**. Size the supply, each distribution branch, hub and cable for the intended simultaneous current. Match the three-pin TTL ports and harnesses to the actual parts. One bench adapter does not supply motor power or implement the force-feedback controller. [U2D2 wiring and power](https://emanual.robotis.com/docs/en/parts/interface/u2d2/) · [XM430 electrical specifications](https://emanual.robotis.com/docs/en/dxl/x/xm430-w210/) · [XC330 electrical specifications](https://emanual.robotis.com/docs/en/dxl/x/xc330-t288/)
