RenoZhao19/Hexfellow-Teleop-Leader-Arm-Design/(commit log)

2026-11-11 Add Hexfellow teleop leader CAD, validation and file guide
    [Arm_assembly_clearances.csv, Arm_joint_interfaces.csv, Bilateral_grip_clearance.csv, Bimanual_leader.step, CAD_parts_and_quantities.csv, F01_Arched_torso.step, F01_Arched_torso.stl, F02_Flared_table_foot.step]
2026-11-11 Show four assembly views and trigger travel at the top of the README
2026-11-11 Document the round-shoulder build and correct insert and grip fastener fits
    [Bimanual_leader.step, CAD_parts_and_quantities.csv, Gravity_estimates.csv, Gravity_part_masses.csv, Grip_fastener_fit.csv, Grip_released.step, Grip_squeezed.step, J03_Servo_cassette.step]
2026-11-11 Release the external-drum Hexfellow leader and its build guides
    [Arm_joint_interfaces.csv, Bimanual_leader.step, CAD_parts_and_quantities.csv, F01_Arched_torso.step, F01_Arched_torso.stl, F03_Square_mast_40x40x2_L453.step, Gravity_estimates.csv, Gravity_part_masses.csv]
2026-11-11 Use the new CAD screenshots and document every repository folder
